friscv/friscv-ihp-sg13cmos5l/target/ihp-sg13cmos5l/ip/chip_art/image/art_qr.png

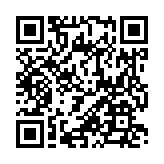
target/ihp-sg13cmos5l/ip/chip_art/image/art_qr.png
