friscv/friscv-ihp-sg13cmos5l/(commit log)

2026-10-04 add ulx3s test board
2026-10-04 pynq z2 target and sd fix
    [chip_soc.sv]
